Ari-Hetti/Quadcopter-Flight-Controller/Assets/While Building/FPV System.png

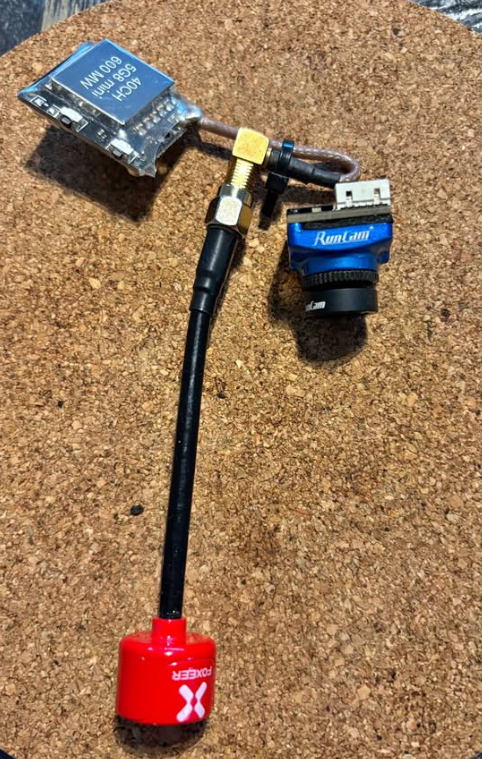
Assets/While Building/FPV System.png
