Ari-Hetti/Quadcopter-Flight-Controller/Assets/Final/Corner View.png

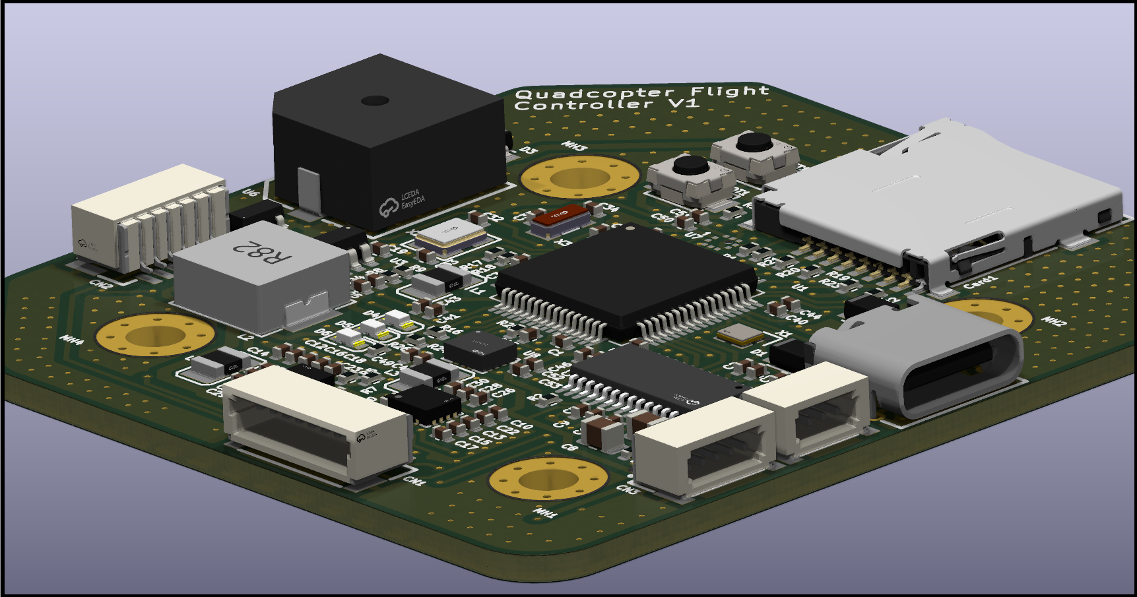
Assets/Final/Corner View.png
