Ari-Hetti/Quadcopter-Flight-Controller/Assets/Corner View 3d.png

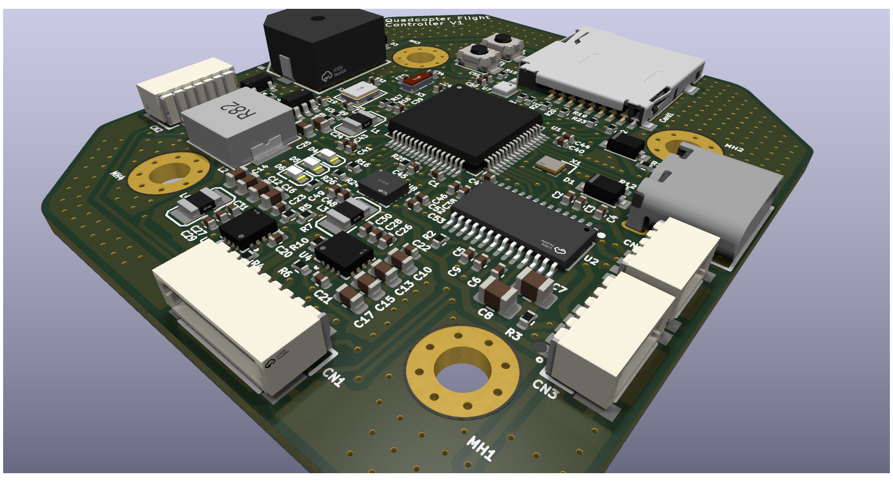
Assets/Corner View 3d.png
