Ari-Hetti/Quadcopter-Flight-Controller/Assets/Final/Back Copper Layer.png

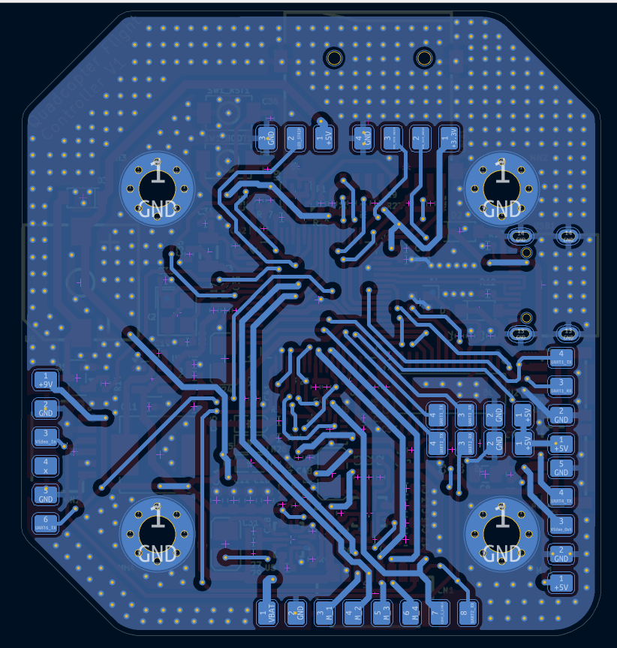
Assets/Final/Back Copper Layer.png
