Ari-Hetti/Quadcopter-Flight-Controller/Assets/Final/Front Copper Layer.png

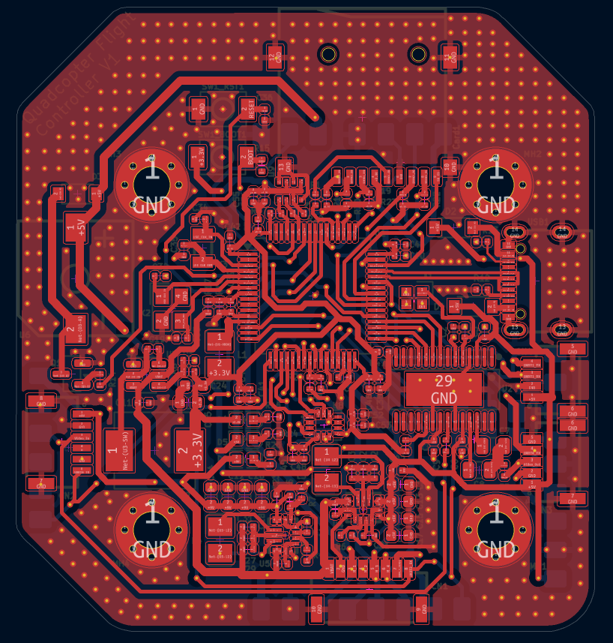
Assets/Final/Front Copper Layer.png
