Ari-Hetti/Quadcopter-Flight-Controller/Assets/Final/JLCPCB Preview.png

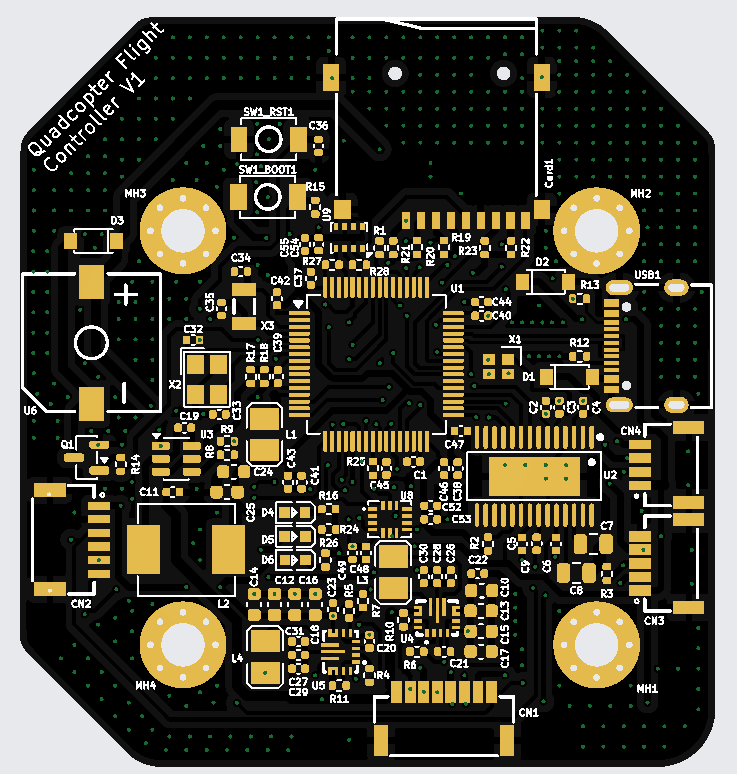
Assets/Final/JLCPCB Preview.png
