Ari-Hetti/Quadcopter-Flight-Controller/Assets/Final/Misc Page.png

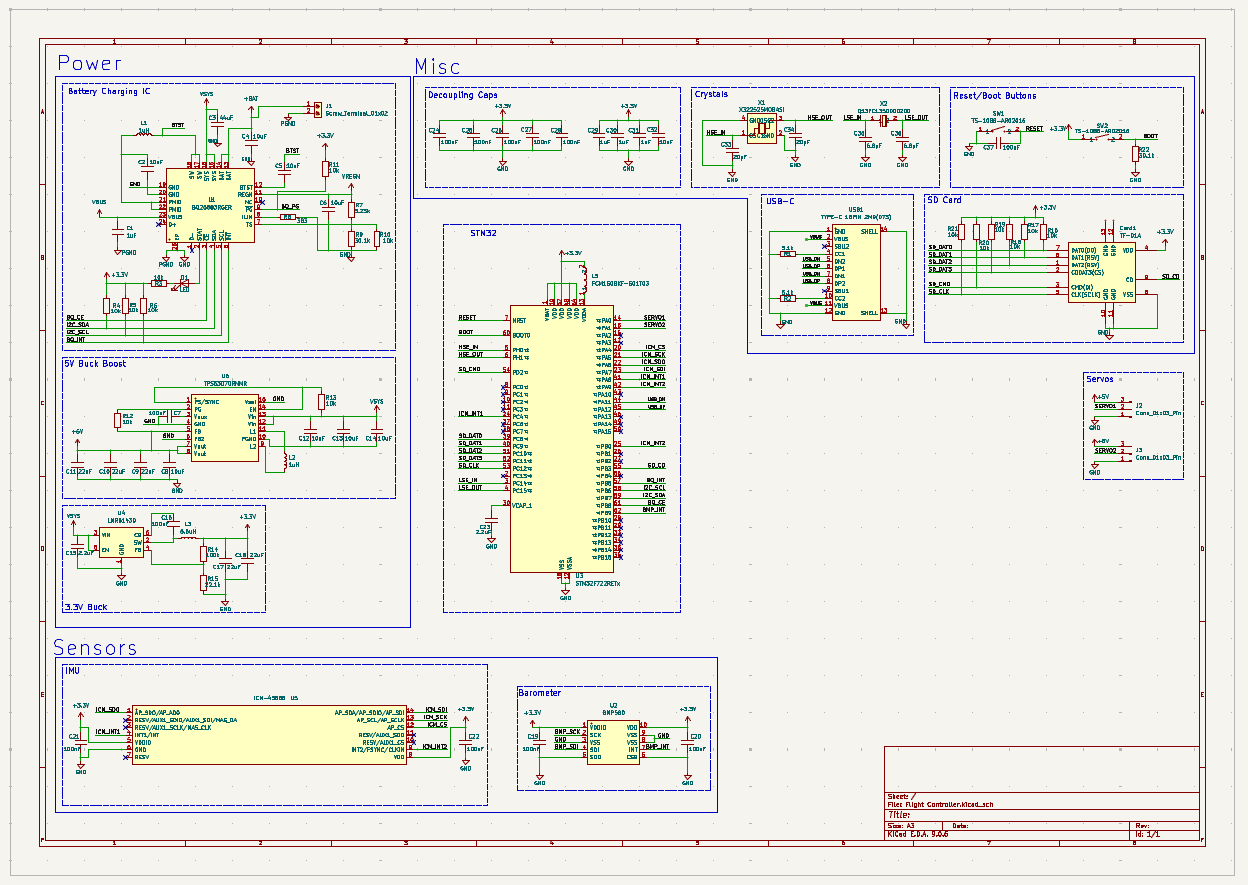
Assets/Final/Misc Page.png
