Ari-Hetti/Quadcopter-Flight-Controller/Assets/Final/PCB Overview.png

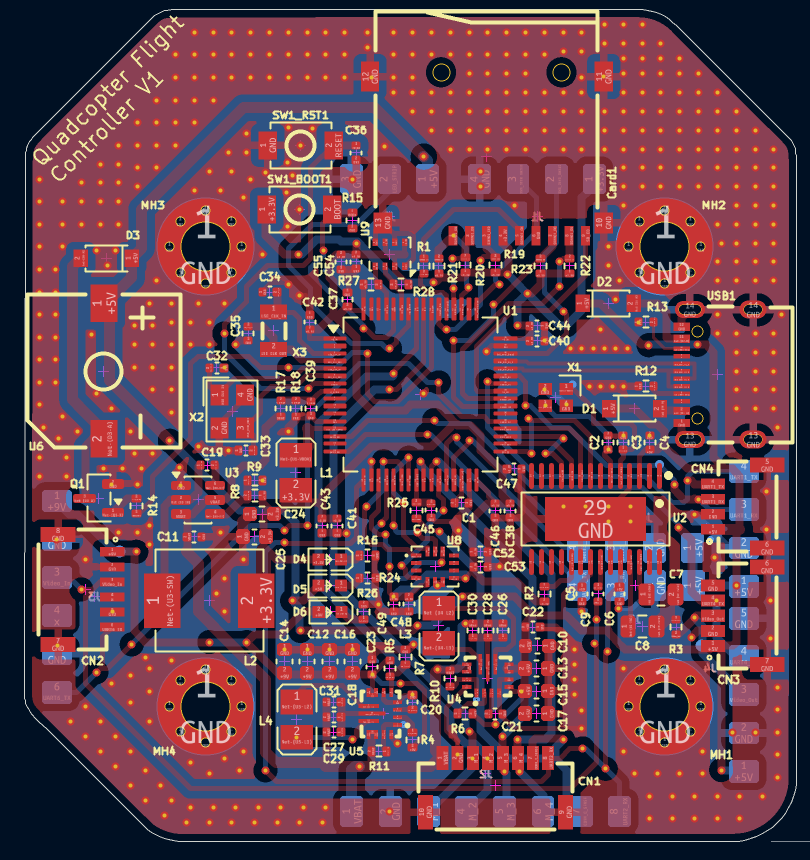
Assets/Final/PCB Overview.png
