Ari-Hetti/Quadcopter-Flight-Controller/Assets/Final/Power Page.png

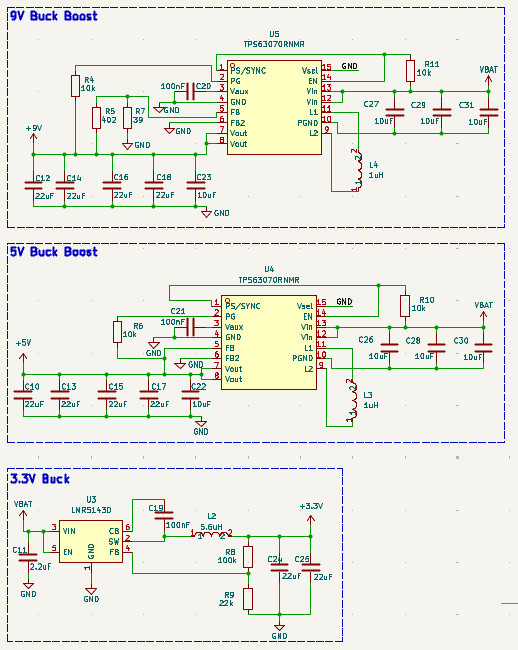
Assets/Final/Power Page.png
