Ari-Hetti/Quadcopter-Flight-Controller/Assets/Final/Root Page.png

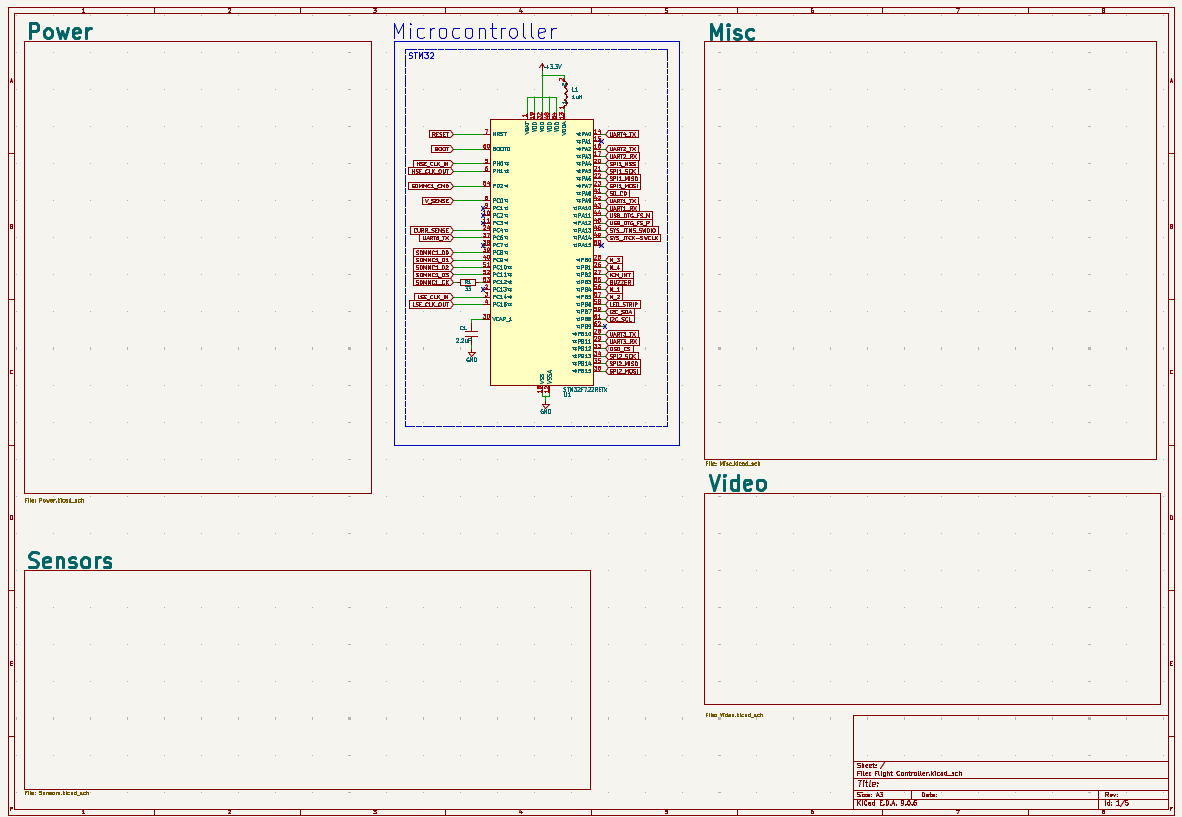
Assets/Final/Root Page.png
