Ari-Hetti/Quadcopter-Flight-Controller/Assets/Final/Sensor Page.png

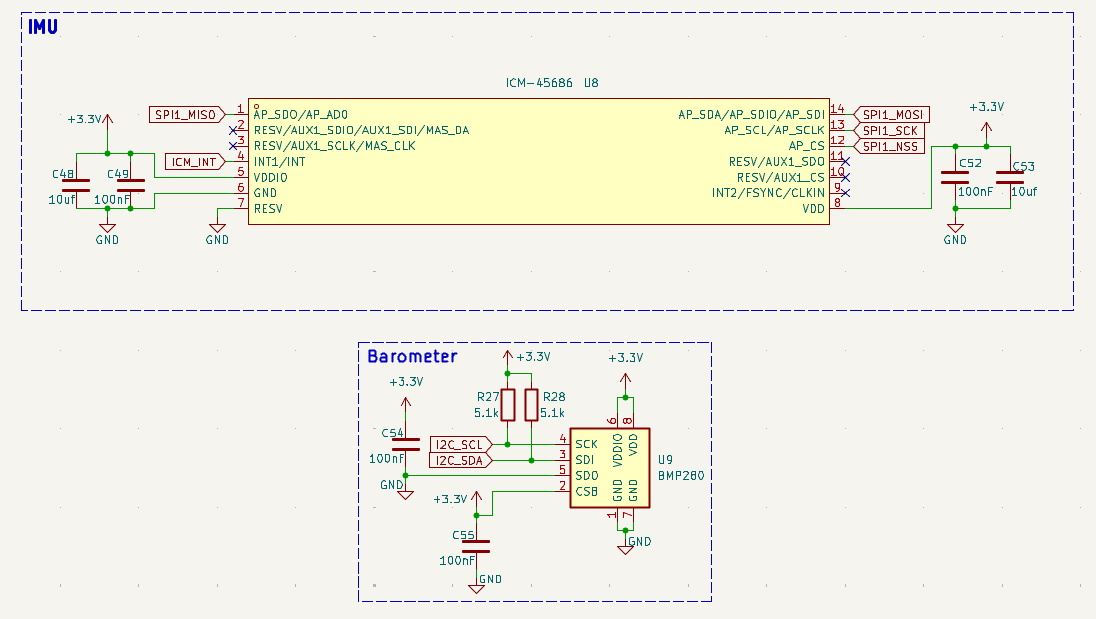
Assets/Final/Sensor Page.png
