Ari-Hetti/Quadcopter-Flight-Controller/Assets/Final/Top Down View No Raytrace.png

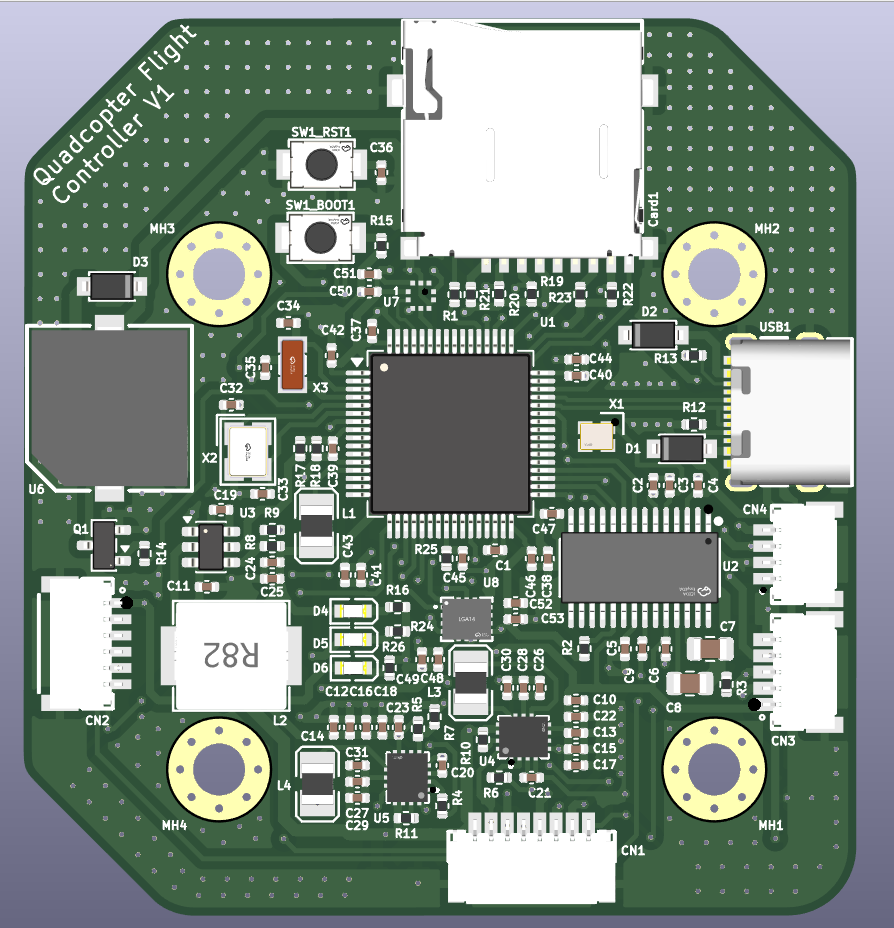
Assets/Final/Top Down View No Raytrace.png
