Ari-Hetti/Quadcopter-Flight-Controller/Assets/Final/Video Page.png

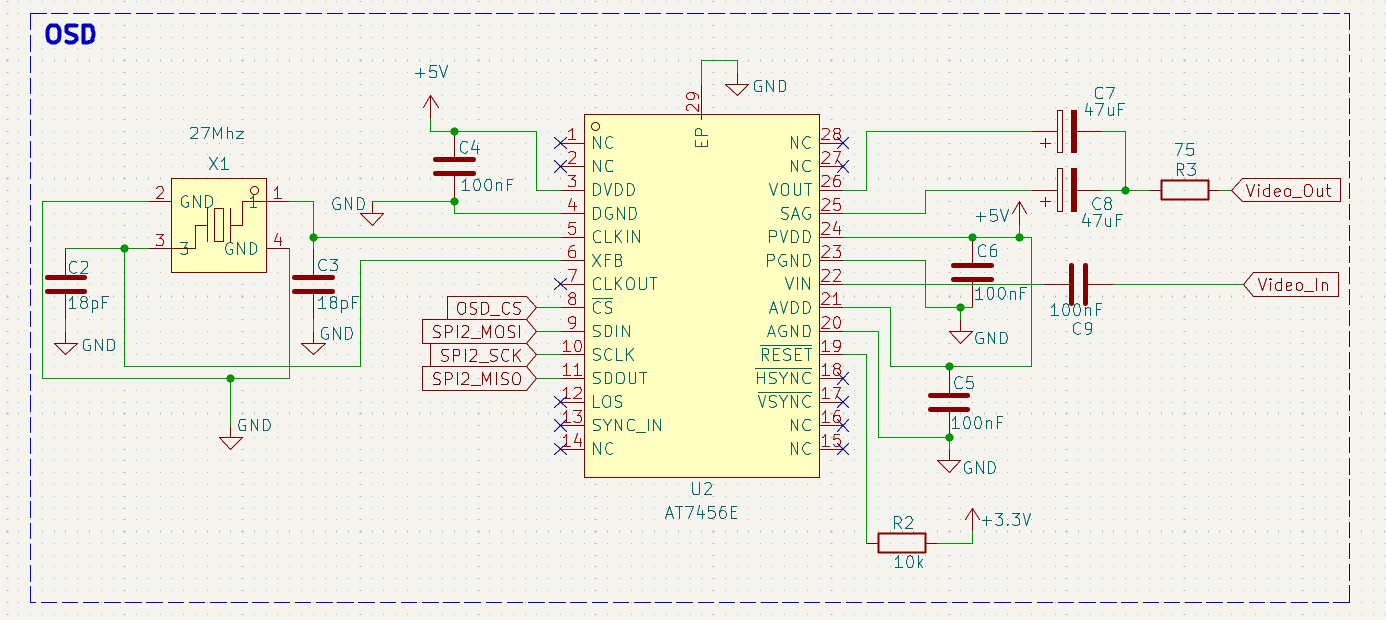
Assets/Final/Video Page.png
