Ari-Hetti/Quadcopter-Flight-Controller/Assets/Front View.png

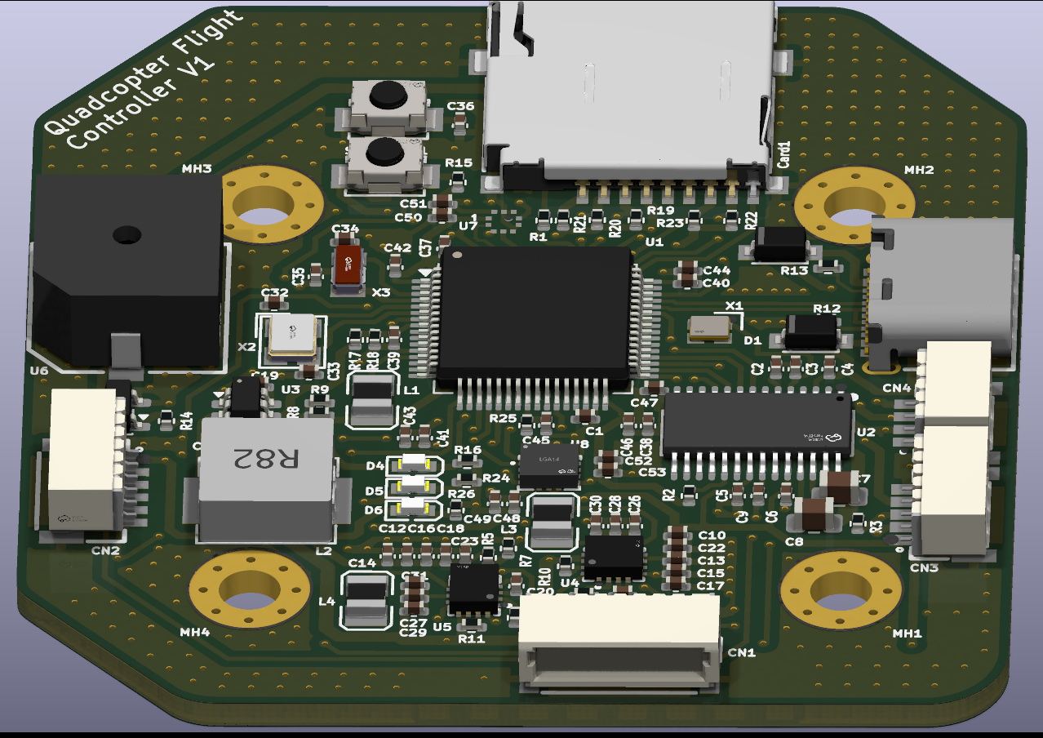
Assets/Front View.png
