Ari-Hetti/Quadcopter-Flight-Controller/Assets/Top Down View.png

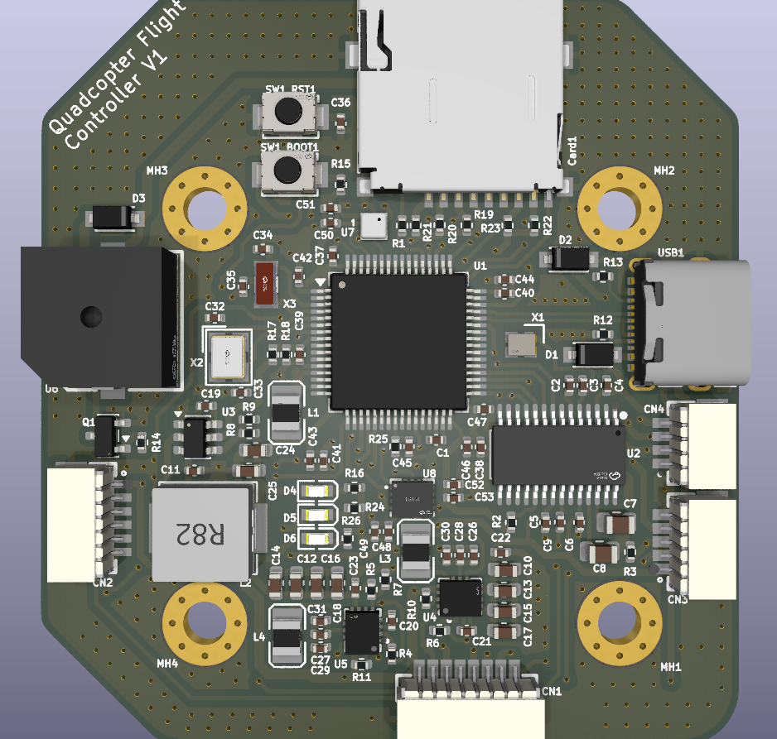
Assets/Top Down View.png
