Ari-Hetti/Quadcopter-Flight-Controller/Assets/While Building/Screenshot 2026-03-14 205332.png

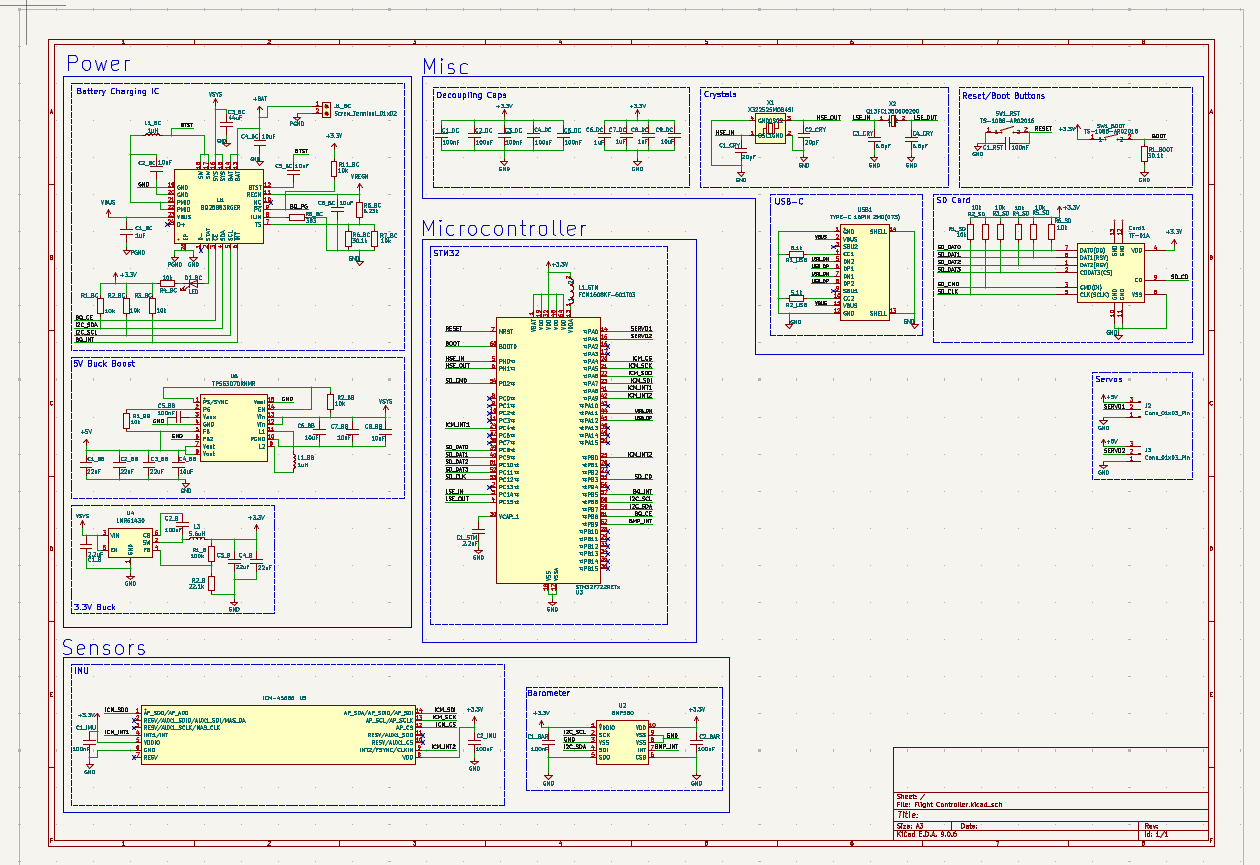
Assets/While Building/Screenshot 2026-03-14 205332.png
