Ari-Hetti/Quadcopter-Flight-Controller/Assets/While Building/Screenshot 2026-03-16 011956.png

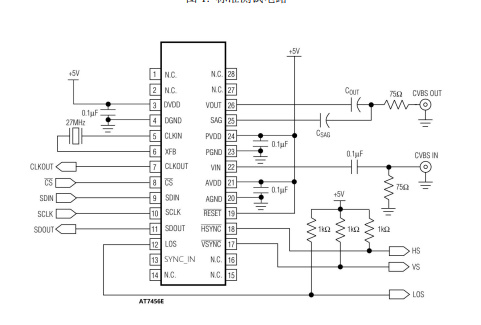
Assets/While Building/Screenshot 2026-03-16 011956.png
