Ari-Hetti/Quadcopter-Flight-Controller/Assets/While Building/Screenshot 2026-03-16 220547.png

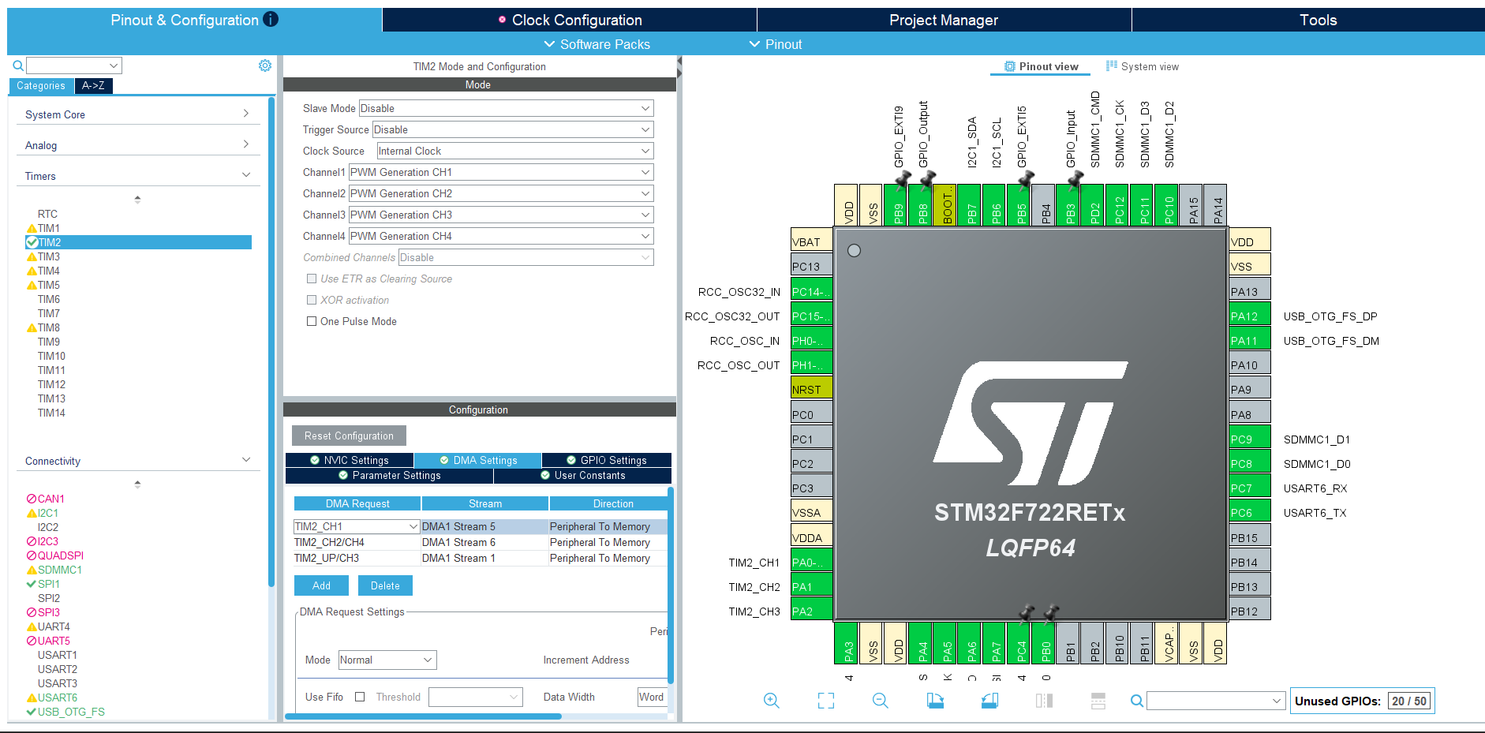
Assets/While Building/Screenshot 2026-03-16 220547.png
