Ari-Hetti/Quadcopter-Flight-Controller/Assets/While Building/Screenshot 2026-03-19 233206.png

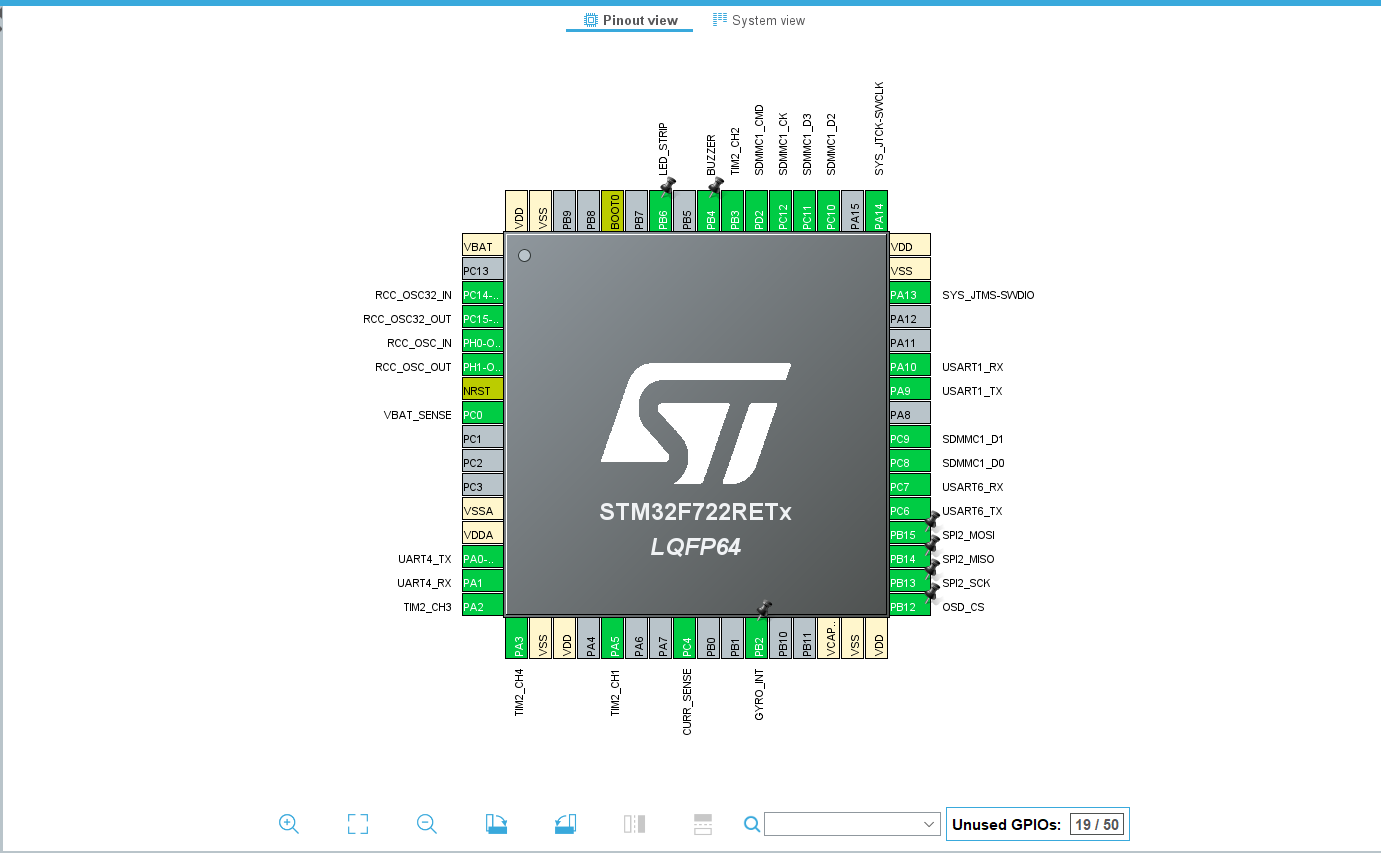
Assets/While Building/Screenshot 2026-03-19 233206.png
