Ari-Hetti/Quadcopter-Flight-Controller/Assets/While Building/Screenshot 2026-03-22 210359.png

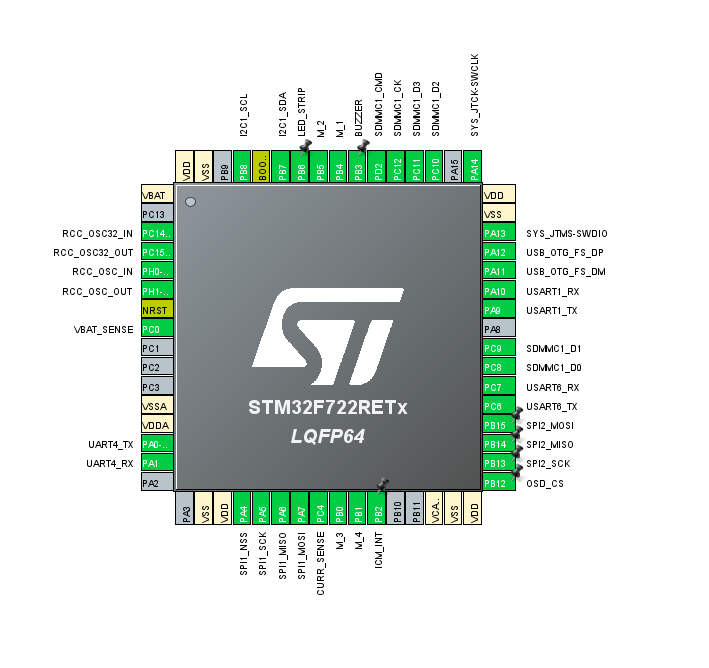
Assets/While Building/Screenshot 2026-03-22 210359.png
