Ari-Hetti/Quadcopter-Flight-Controller/Assets/While Building/Screenshot 2026-03-25 163328.png

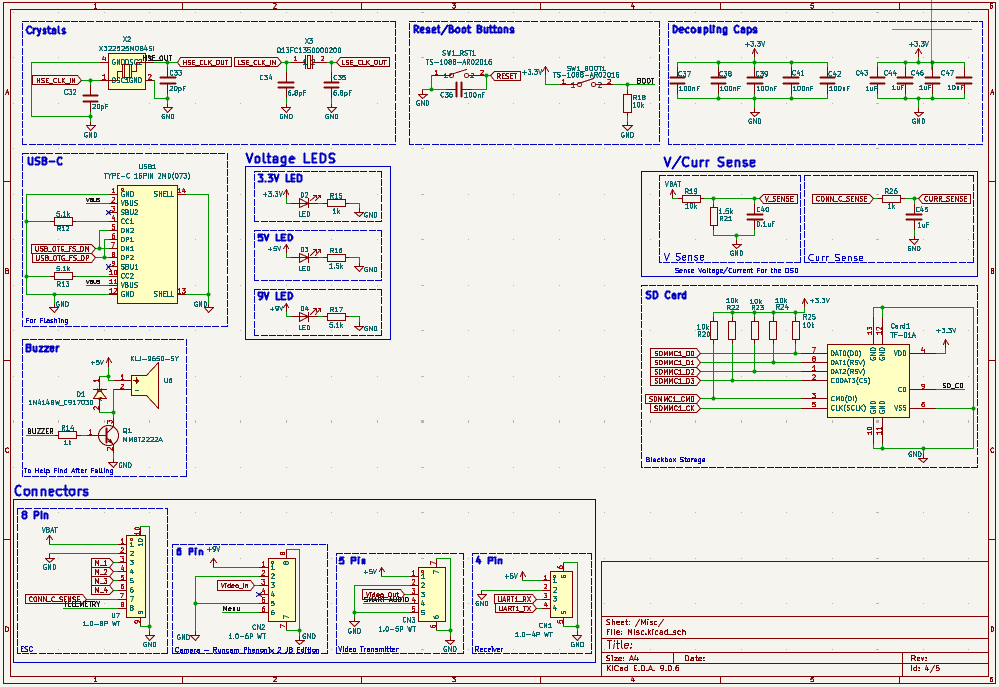
Assets/While Building/Screenshot 2026-03-25 163328.png
