Ari-Hetti/Quadcopter-Flight-Controller/Assets/While Building/Screenshot 2026-03-27 222922.png

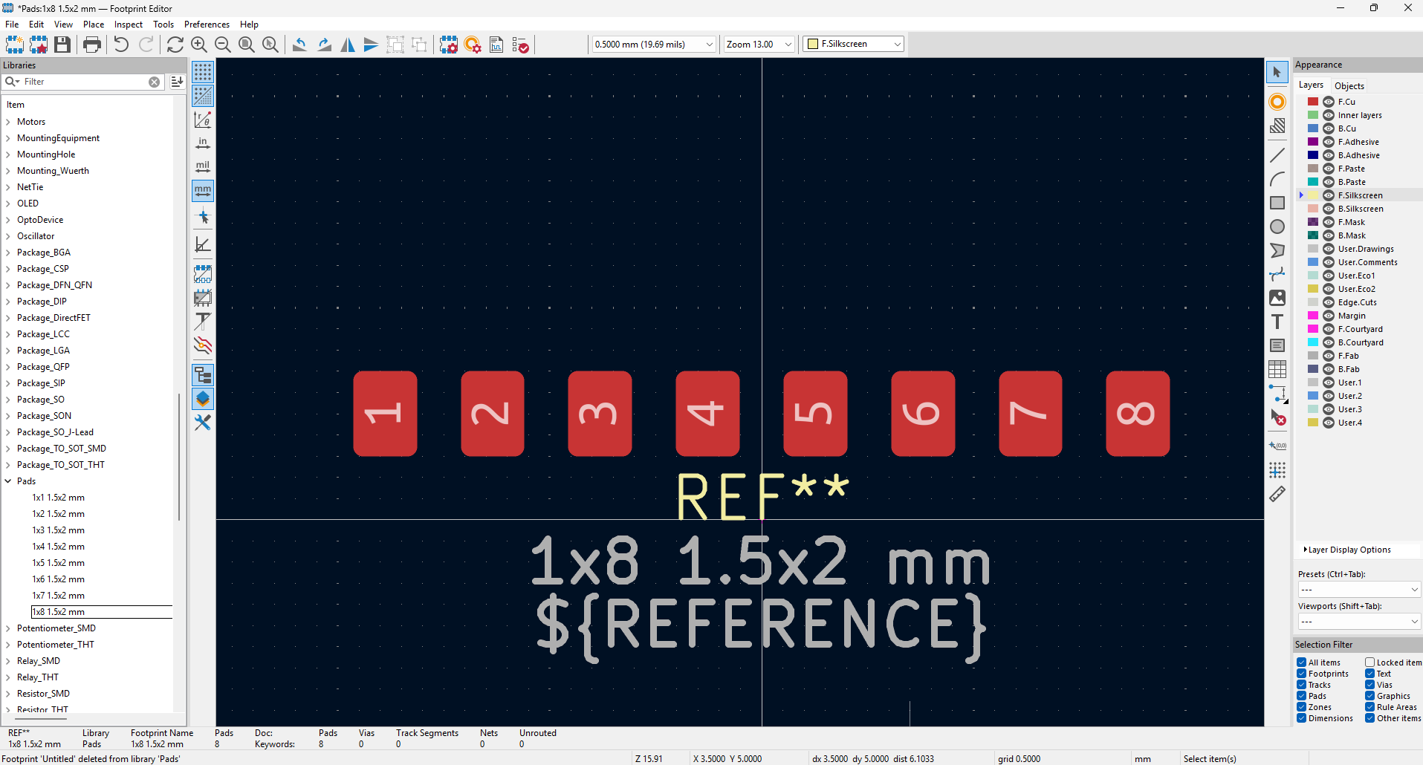
Assets/While Building/Screenshot 2026-03-27 222922.png
