Ari-Hetti/Quadcopter-Flight-Controller/Assets/While Building/Screenshot 2026-04-10 103412.png

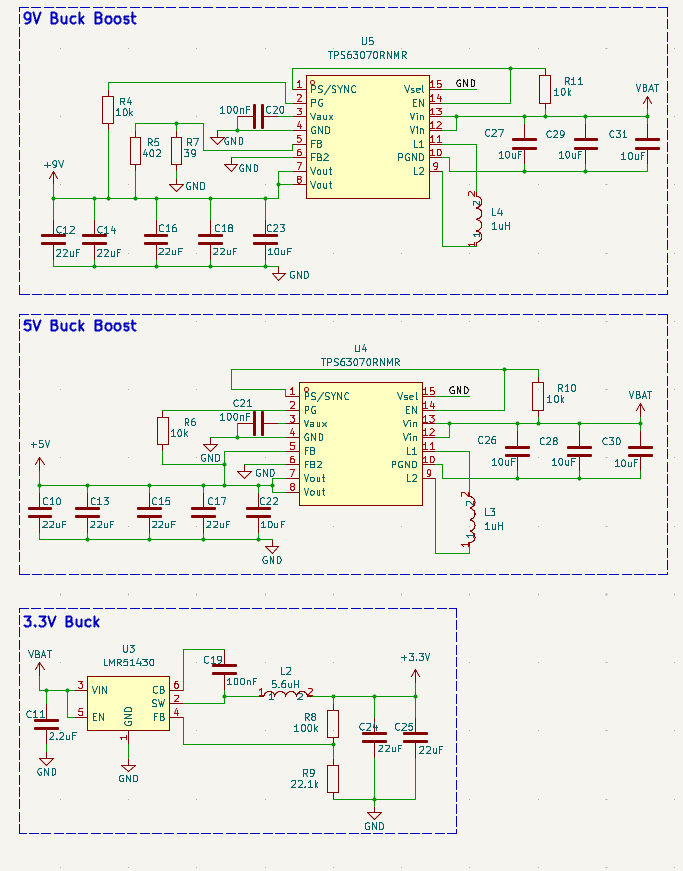
Assets/While Building/Screenshot 2026-04-10 103412.png
