Ari-Hetti/Quadcopter-Flight-Controller/Software/Software.ioc

Mcu.UserName=STM32F722RETx
PA0-WKUP.Signal=UART4_TX
PA1.Signal=UART4_RX
PA10.Signal=USART1_RX
PA13.Signal=SYS_JTMS-SWDIO
PA14.Signal=SYS_JTCK-SWCLK
PA2.Signal=S_TIM2_CH3
PA3.Signal=S_TIM2_CH4
PA5.Signal=S_TIM2_CH1_ETR
PA9.Signal=USART1_TX
PB12.GPIO_Label=OSD_CS
PB12.Signal=GPIO_Output
PB13.Signal=SPI2_SCK
PB14.Signal=SPI2_MISO
PB15.Signal=SPI2_MOSI
PB2.GPIO_Label=GYRO_INT
PB2.Signal=GPXTI2
PB3.Signal=S_TIM2_CH2
PB4.GPIO_Label=BUZZER
PB4.Signal=GPIO_Output
PB6.GPIO_Label=LED_STRIP
PB6.Signal=S_TIM4_CH1
PC0.GPIO_Label=VBAT_SENSE
PC0.Signal=ADCx_IN10
PC10.Signal=SDMMC1_D2
PC11.Signal=SDMMC1_D3
PC12.Signal=SDMMC1_CK
PC14-OSC32_IN.Signal=RCC_OSC32_IN
PC15-OSC32_OUT.Signal=RCC_OSC32_OUT
PC4.GPIO_Label=CURR_SENSE
PC4.Signal=ADCx_IN14
PC6.Signal=USART6_TX
PC7.Signal=USART6_RX
PC8.Signal=SDMMC1_D0
PC9.Signal=SDMMC1_D1
PD2.Signal=SDMMC1_CMD
PH0-OSC_IN.Signal=RCC_OSC_IN
PH1-OSC_OUT.Signal=RCC_OSC_OUT
