Ari-Hetti/Quadcopter-Flight-Controller/(commit log)

2026-02-17 Finished Schematic tutorial
    [Flight Controller.kicad_sch]
2026-04-14 Finish Project
    finally done
    [Flight Controller - Before Changes.kicad_sch, Flight Controller.kicad_pcb, Flight Controller.kicad_sch, Misc.kicad_sch, Power.kicad_sch, Sensors.kicad_sch, Video.kicad_sch, bom.csv]
2026-04-14 Update README with design images and views
    Added schematics, PCB images, and 3D views to the README.
2026-04-14 Add BOM section to README
    Added BOM section with components, quantities, and costs.
2026-04-17 Revise README with project details and BOM updates
    Updated project description and added links to project page and guides. Modified BOM to reflect accurate quantities and costs.
2026-04-17 Add Full BOM
    [Quadcopter Flight Controller-bom (1).csv]
2026-04-26 Lock In Twin
    [Flight Controller.kicad_pcb]
2026-04-27 Refine README formatting and enhance BOM links
    Updated section headers and added links to BOM items.
